SebastienBocquet/ConvertibleUAV/docs/source/figs.pptx

Integral(t)

Limiter

*(-Ki)

actual

target

*(-Kp)

PID block

+

output

Delta(t)

Low pass filter

*(-Kd)

## Slide 2

roll angle

commanded
roll

PID

roll rate

desired roll rate

PID

roll_quad_ control

## Slide 3

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
## Slide 4

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
## Slide 5

C

alpha

G

RB

RA

y

B

A

x
