SebastienBocquet/ConvertibleUAV/docs/source/figs/model/motor_tilt.png

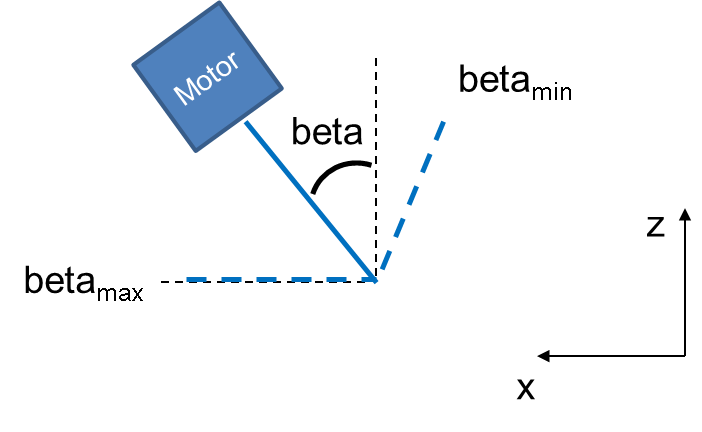
docs/source/figs/model/motor_tilt.png
