SebastienBocquet/ConvertibleUAV/(threads)

Thread 1 (2017-12-27):

refactoring

SebastienBocquet, 2017-12-27:
create dedicated sonarAltitude.c for sonar altitude estimation
create dedicated lidarAltitude.c for lidar altitude estimation
rename estAltitude.c in barometerAltitude.c

SebastienBocquet, 2019-04-13:
Refactoring of motorControl.c: work in progress on branch refactored-motorcontrol.
Functional test shows an instability in roll and pitch control.
Debug to be done
