SebastienBocquet/ConvertibleUAV/(commit log)

2016-06-25 Flight in GPS mode OK. Control of hovering roll and pitch via FLAP_INPUT_CHANNEL and CAMERA_PITCH_INPUT_CHANNEL. Read_txt_log.py modified: common functions put in lib.py, ability to modify values in 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
2016-07-22 creation of a function to computate servo orders from potentiometer orders correction in the estimation of vertical velocity from altitude sensors.
2016-10-30 attempt to run at 200Hz. Does not seem to run (nothing written in log). To be debugged
2016-10-31 add motorCntrl.c, just make necessary mods to compile. Quad mode should work in pure manual mode
2016-11-02 working at 160Hz, with serial_udb_light output at 80Hz OK
2016-11-10 motorCntrl, in particular PID controllers debugged (derivatives not used and to be debugged). first test seems to show stable drone
2016-11-22 magnetometer and barometer connected by i2c are working. Hovering with manual altitude control seems stable
2016-12-01 hovering OK with alitude control by sonar. Testing of new formulation of expo filter and sga derivative in progress
2016-12-17 motor control seems bugged (oscillations on pitch axis)
2017-01-06 controle en roulis et tangage OK (gains a regler). Controle en lacet OK avec rampe progressive sur 3s quiest activee des que le sonar est valide. rampe sur throttle_control dans altitude control en p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
2017-01-09 correction bug on activation of integral terms of motor cntrl PID. correction frequency of i2c reading fr magnetometer and barometer (made dependent on HEARTBEAT_HZ to be general for different HEARTB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
2017-02-27 control gains of motorCntrl OK for heartbeat_hz = 160Hz and ESC_HZ=80Hz. Drone relatively stable (outdoor test) Add separate management of pwm outputs: PWM 1 to 4 are at ESC_HZ. PWM 5 to 8 are at SER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
2017-03-04 Management of PWM outputs using timers (2+2+4). implementation of filtering on togoal (untested). Implementation of derivative of tilt rate (degugged but not tested in flight)
2017-04-20 implementation of derivative term of PIDs. SGA derivative tested but not used. Outdoor test shows stable drone with altitude control activated. Flight operated during ne battery pack.
2017-12-27 Modification of take-off sequence. Failsafe mode in case of lost radio signal or low battery
2017-12-27 Deactivate sonar orientation control via servo. Added Documentation : User guide
2018-01-17 Added lidar sensor, Refactoring of altitude sensor management.
2018-03-05 Added wireless telemetry capability through nrf905 transmitters Added dedicated telemetry section in telemetry.c, Arduino library for nrf905, python real time plotting based on PyQT
2018-05-17 Added filtering of servo outputs. More robust handling of bad sensor altitude reading. Added specific telemetry output for wireless link.
2018-07-09 Finalisation algo de positionnement sur point GPS en hovering.
2018-08-18 Mise en place procedure de validation basee sur des flags Test*. Correction de la detection de panne capteur d'altitude
2018-08-18 Ajout document de validation pre-vol
2018-09-04 Desactivation de l'atterrissage forcé en cas de batterie faible. Detection batterie a tester
2018-09-04 Gestion du throttle en normal/hovering et manual/stabilized modes
2018-09-30 Refactoring de la logique qui gere les phases de vol
2018-10-03 Increase of altitude control PID gains
2018-10-03 Gestion des flags de test Permet maintenant de jouer entre manual et stabilized
2018-10-04 Corrections sur le mecanisme TestGains pour accepter le switch manual/stabilized
2018-10-05 Nettoyage de variables dediees a la telemetrie
2018-10-05 Modification du mecanisme de reset de variables du controle d'altitude
2018-10-05 signe moins sur une variable de telemetrie pour lisibilite
2018-10-05 Ajout routine d'estimation de l'altitude
2018-10-05 Correction sur la rampe de decroissance du throttle en mode auto-land
2018-10-07 Modification de l'activation du calcul d'altitude et du controle d'altitude en hovering
2018-10-07 Pres du sol seul le lidar est pris en compte. Gestion du passage de stabilized a manuel durant les phase de vol in-flight et auto-land
2018-10-07 Modification activation du controle roll, yaw et pitch en hovering
2018-10-07 Correction decroissance du throttle en auto-land
2018-10-12 Mise a jour procedure de recette
2018-10-12 AJout sorties telemetries du throttle de chaque moteur et de la moyenne
2018-10-31 Correction throttle en phase auto land. Ajout phase de vol engine off
2018-11-09 Ajout fonction pour gérer les rampes
2018-11-09 removed emergency landing
2018-11-11 Robustesse yaw control en hovering
2018-12-03 Correction in buzzer activation. Output throttle channel set to unused
2018-12-20 Activate buzzer in case of sensor failure of low battery
2018-12-25 First test on motorCntrl
2018-12-26 Added one test on motor control
2018-12-28 Modified detection of magnetometer hardware failure
2018-12-28 Added sensor failure flags to telemetry
2018-12-29 Modified detection of low battery
2019-03-30 Enable arbitrary yaw heading at initialization
2019-04-08 Remove yaw control toward yaw_control in automatic mode
    It was causing a discontinuity in yaw control if the initial
    yaw orientation is not toward the north
2019-05-03 Increase telemetry rate
    10Hz OK for about 14 variables
2019-05-03 Set altitude control to 160Hz
2019-05-16 Set PID gains of altitude control to constant value
2019-05-30 Fix detection of altitude sensor failure
2019-05-30 Fix activation of sensor failure mode
2019-08-13 Trigger normal to hovering flight depending on motor pitch angle
2019-08-13 WIP Fix motor pitch servo control
2019-08-13 Fix motor pitch control
2019-08-13 Deactivate altitude sensors
2019-08-13 Remove call to functions that manage alitude sensors
2019-08-13 Call altitude control at SERVO_HZ
2019-08-13 Remove low pass filtering on roll, yaw and pitch pwm
2019-08-13 Remove useless code in yaw control in hovering
2019-08-15 Add function to deactivate integral pid term via RC transmitter switch
2019-08-15 Call function that controls activation of integral pid terms
2019-08-15 Remove useless logic in motor control
2019-08-15 Remove useless code in motor control
2019-08-15 Remove commented code (including Kalman filter prototype)
2019-08-19 Modify condition activating PID integral terms
2019-08-19 Remove forcing to zero of PID intergal terms by TestGains flag
2019-08-20 Fix condition to switch to hovering mode
2019-09-30 Weight yaw control from Tx
2019-10-01 WIP Add test on PID motor control A function which resets the PID needs to be implemented in order to implement several tests in a row
    [test_gains.c]
2019-10-13 Fix test on PID motor control Solution is to use some functions that reset the PID controllers
    [test_gains.c]
2019-10-19 add gains as args of motor control function
2019-10-19 Add test on integral term of PID controller
2019-10-24 Fix yaw control weighting
2019-11-12 feat: add a variable to select magnetometer callback frequency
2019-11-16 Test: add yaw control test
2019-11-16 Refactor: remove debug print and debug variables
2019-11-20 Test: add a test on motor control
2019-11-20 Feat: correct motor outputs to ensure constant mean throttle even when limiters activate
    [test_tilt.c]
2019-12-22 feat: modify control scaling in quadcopter X config Scaling should be frame_control = 0.707 * control for X config, and 0.5 * control or + config. As a result, using the same pid coefficients, and fo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
2019-12-25 doc: add motor control doc for several motor configurations
2019-12-27 doc: fix tricopter pitch control
2019-12-27 tests: modify test arborescence and add a test on quadcopter pitch
2019-12-27 tests: add tests on tricopter roll and pitch controls
2019-12-28 feat: implement tricopter roll and pitch control. Fix tests
    [test_mean_control.c, test_tilt.c]
2019-12-28 refactor: remove prints and add const
2020-01-01 fix: sign of pitch control
2020-01-01 feat: set-up board orientation and channels for quad/tri-plane
2020-01-19 doc: motor control for quad and tri copter
2020-01-19 fix: sign of motor pitch control
2020-01-23 test: renaming in tests and add test on attitude control and motor tilt
2020-01-24 feat: increase yaw control gains
2020-01-24 yaw control using differential motor tilt
2020-01-29 Revert "feat: increase yaw control gains"
    This reverts commit 4af136a4e1fc044ad9cc7d5514d837a80e5d615e.
2020-04-09 doc: fix tilt motor
2020-04-09 feat: WIP add script to parse propeller experimental database and compute propulsion coefs
2020-04-18 doc: simplify tilt control. Improve motor control.
2020-04-18 tests: update following change in tilt control and motor control
2020-04-22 test: fix, use assertion with given accuracy and test limiter on motor throttle
2020-04-22 feat: tilt control and motor control with throttle limiter
2020-04-26 test: yaw control
2020-04-26 feat: script to model motor throttle at max value
2020-04-26 fix: consider case of zero throttle in hovering mode
2020-04-26 feat: update parameters of tricopter geometry and servo control
2020-04-26 fix: sign of tilt angle for yaw compensation
2020-04-26 feat: add throw and trim for one tilt servo
2020-04-29 feat: determine throttle of each engine for given total thrust using propeller database
2020-04-30 fix: type in a print
2020-04-30 fix: throttle limiter model
2020-04-30 fix: throttle limiter
2020-05-01 fix: deactivate yaw control by motor tilting in normal flight mode
2020-05-01 fix: reverse motor tilting for yaw control
2020-05-01 feat: modify tilt motor pwm trim and coef
2020-05-01 fix: motor throttle limiters
2020-05-04 doc: improve propeller modeling, and fix motor control
2020-05-04 feat: improve plot of throttle model
2020-05-04 tests: fix tests after fix in motor control and removal of tilt servo trim
2020-05-04 feat: add possibility to reverse motor roll and pitch control roll or pitch channel reverse is imposed by roll and pitch control surface servo mounting. Thus we need this additional parameters to obt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
2020-06-02 feat: add script to check throttle limiters
2020-06-09 licence: switch to Apache 2.0
2020-08-12 fix: motor controls in normal flight
2020-08-21 doc: describe motor throttle limiter
2020-09-14 feat: use one throw parameter per tilt servo
2020-09-14 fix: buzzer in case of low battery
2020-09-14 feat: activate rudder control
2021-11-14 add ArduPilot params
    [easyglider_vtol.param]
